HaiZeus0411/Infernum-Files/README.md

# Infernum Files
 Open sourced files for Infernum 35% Keyboard.  
This is a work in progress and more files can be uploaded upon request.  
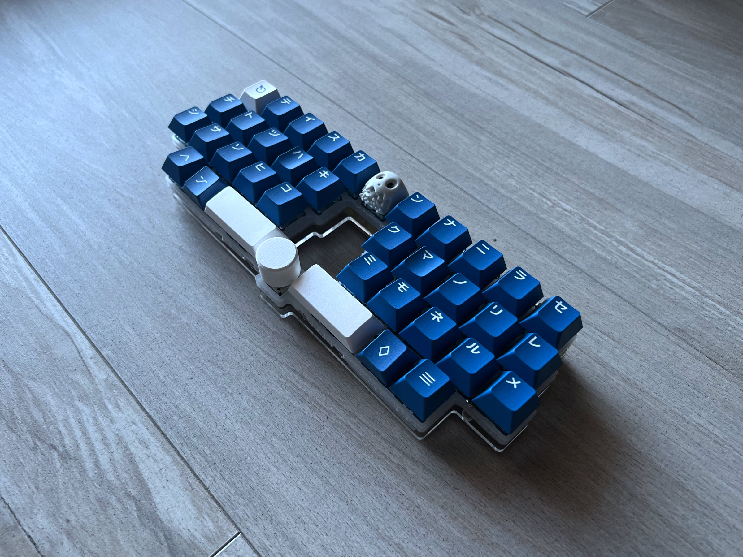
[picture p1: image.jpg]
Skeleton Kit

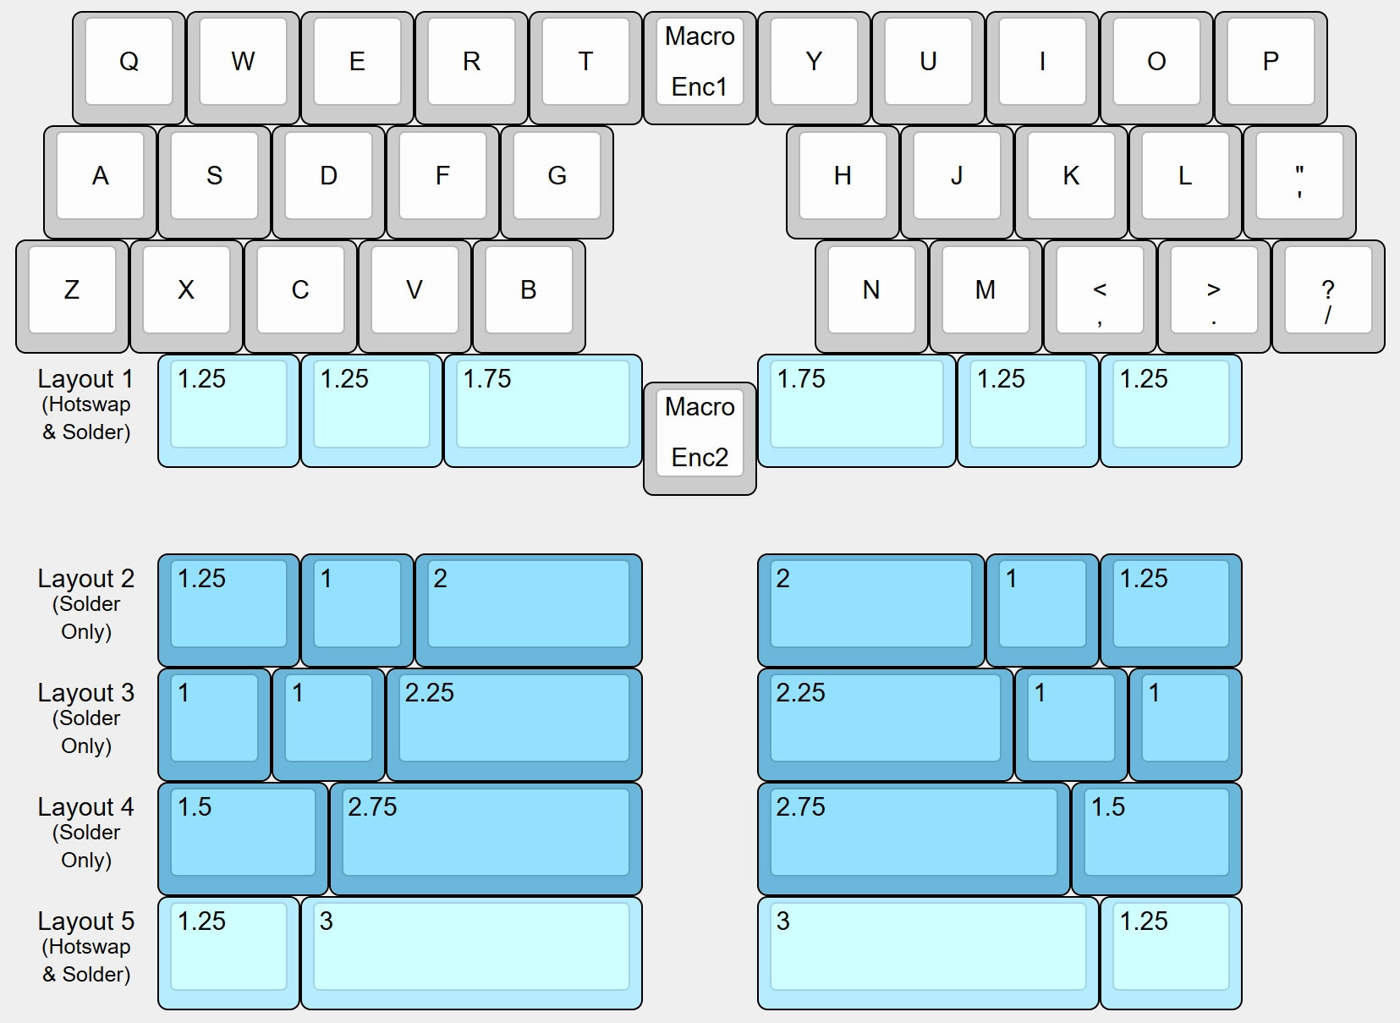
[picture p2: Infernum-Layout.jpg]
KLE
