HaiZeus0411/Infernum-Files/Useful Files for Custom Cases/README.md

# Useful Files for Custom Cases
Note: These files are for use in custom case design. The blocker is not perfectly centered in the center cutout of the PCB, so an additional DXF is provided showing their relative positon. The blocker is 18.50 mm tall and designed for M3x6mm screws.
