HaiZeus0411/Infernum-Files/Case Print Files/Leviathan5Deg_InternalWeight.stl

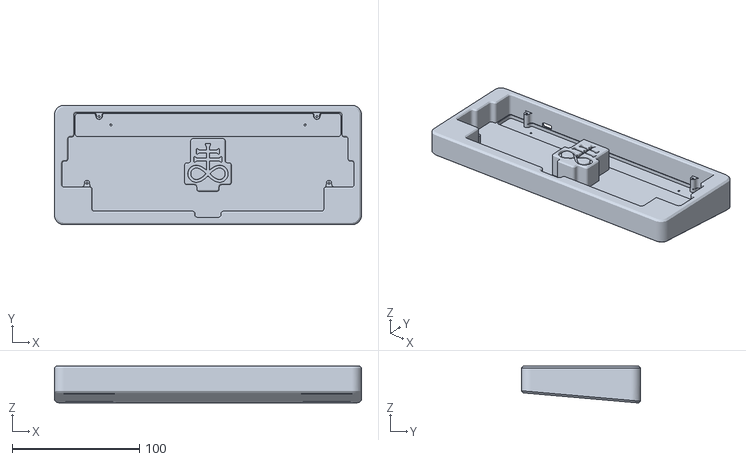
[picture p3: CAD file, 2024-08-07]
Case Print Files/Leviathan5Deg_InternalWeight.stl
241.6 x 94.0 x 29.1
