HaiZeus0411/Infernum-Files/Switch Plate Files/Infernum/HotswapPlate.dxf

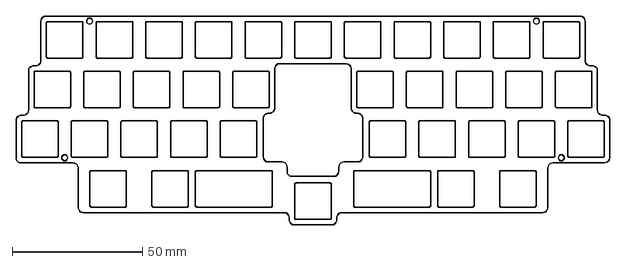
[picture p4: CAD file, 2025-10-07]
Switch Plate Files/Infernum/HotswapPlate.dxf
227.8 x 80.2 mm
