HaiZeus0411/Infernum-Files/Switch Plate Files/Pantagruel/PantagruelNaeviesPlate_M2Threaded.dxf

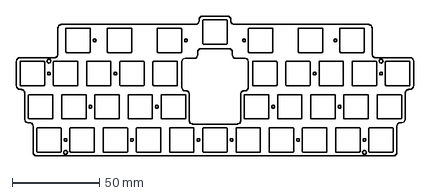
[picture p5: CAD file, 2025-11-03]
Switch Plate Files/Pantagruel/PantagruelNaeviesPlate_M2Threaded.dxf
227.8 x 80.2 mm
