HaiZeus0411/Infernum-Files/Useful Files for Custom Cases/Infernum PCB.step

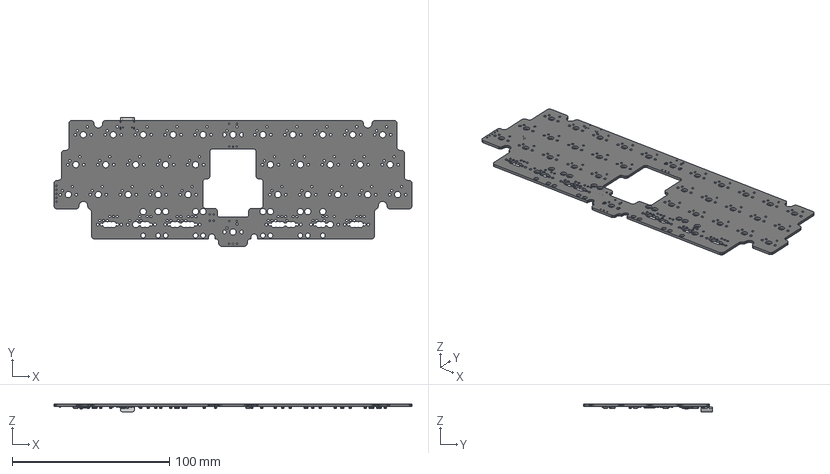
[picture p6: CAD file, 2025-10-07]
Useful Files for Custom Cases/Infernum PCB.step
227.8 x 81.9 x 4.84 mm
PCB
