HaiZeus0411/Infernum-Files/Case Print Files/5DegCase_ResinBlocker_InternalWeight.stl

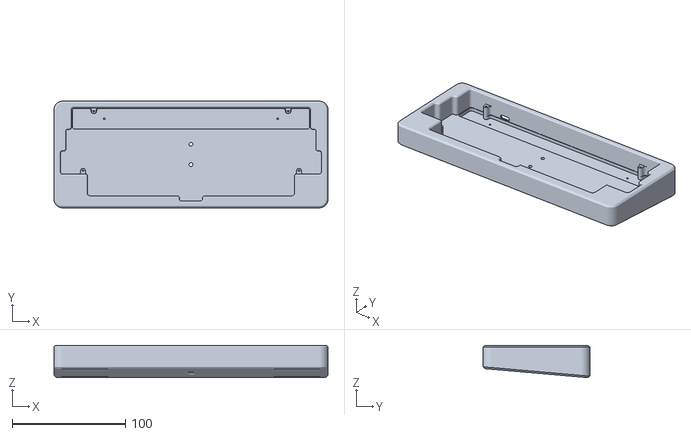
[picture p7: CAD file, 2024-08-07]
Case Print Files/5DegCase_ResinBlocker_InternalWeight.stl
241.6 x 94.0 x 28.6
