HaiZeus0411/Infernum-Files/Switch Plate Files/Infernum/UniversalThickPlate.stl

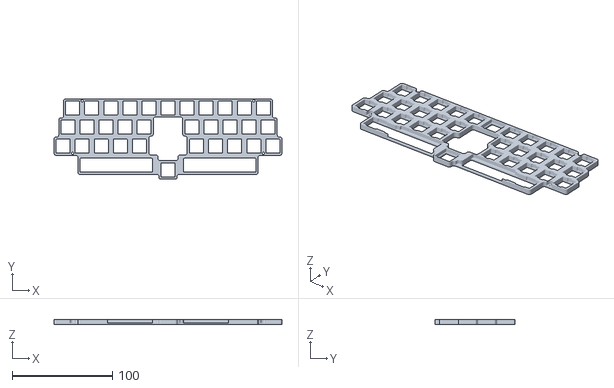
[picture p8: CAD file, 2025-10-07]
Switch Plate Files/Infernum/UniversalThickPlate.stl
227.8 x 80.2 x 4.75
