HaiZeus0411/Infernum-Files/Switch Plate Files/Infernum/175u_3u_ThickPlate_HotSwapLayouts.stl

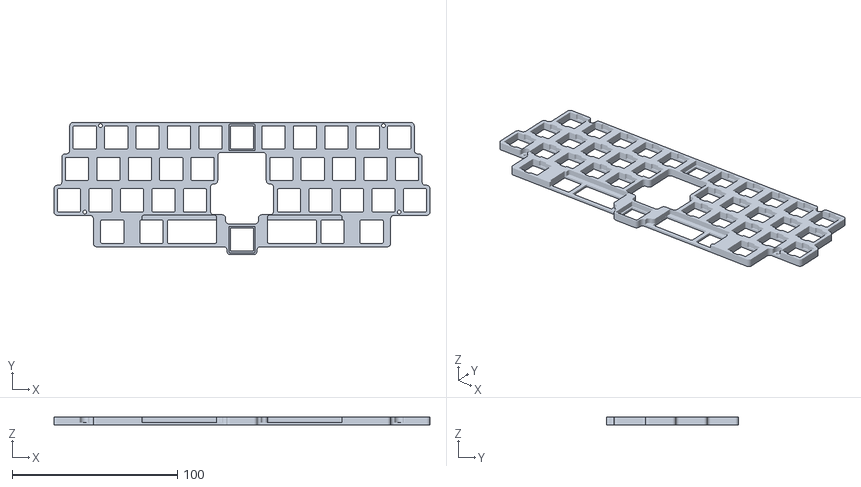
[picture p11: CAD file, 2025-10-07]
Switch Plate Files/Infernum/175u_3u_ThickPlate_HotSwapLayouts.stl
227.8 x 80.2 x 4.75
