HaiZeus0411/Infernum-Files/Switch Plate Files/Pantagruel/PantagruelToprePlate_M2Through.dxf

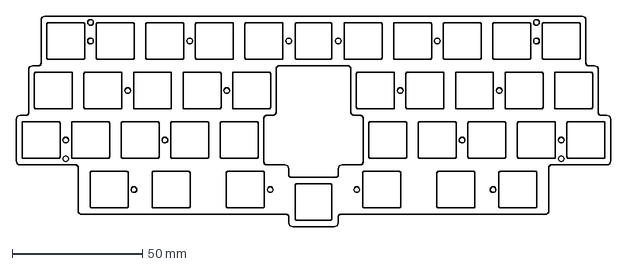
[picture p12: CAD file, 2025-10-07]
Switch Plate Files/Pantagruel/PantagruelToprePlate_M2Through.dxf
228.6 x 81.0 mm
