HaiZeus0411/Infernum-Files/Useful Files for Custom Cases/Infernum PCB Edge Cut with Blocker.dxf

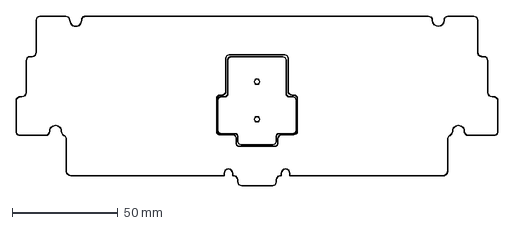
[picture p13: CAD file, 2025-10-07]
Useful Files for Custom Cases/Infernum PCB Edge Cut with Blocker.dxf
227.8 x 80.2 mm
