HaiZeus0411/Infernum-Files/Case Print Files/Trinity5Deg.stl

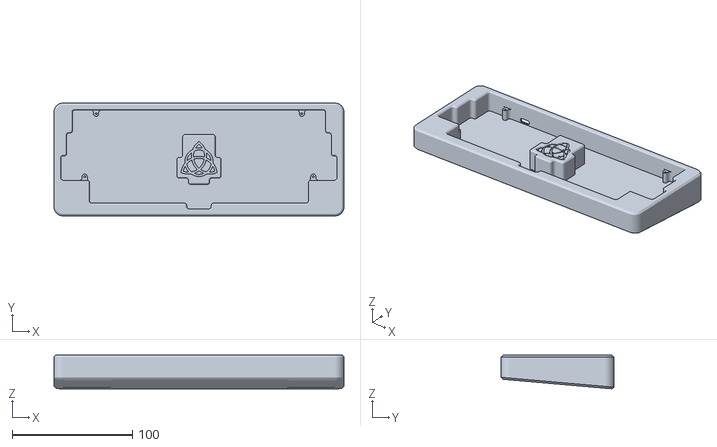
[picture p14: CAD file, 2023-12-13]
Case Print Files/Trinity5Deg.stl
241.6 x 94.0 x 28.1
