HaiZeus0411/Infernum-Files/Switch Plate Files/Infernum/175u_2u_ThickPlate.stl

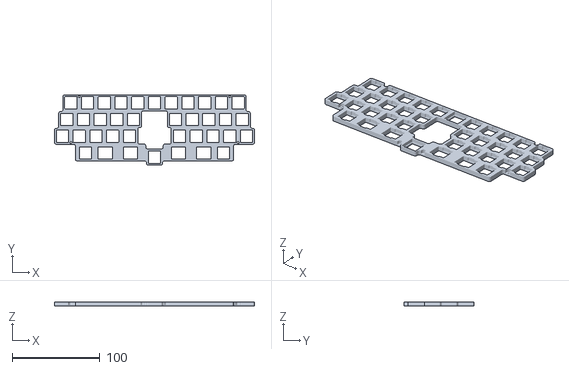
[picture p15: CAD file, 2025-10-07]
Switch Plate Files/Infernum/175u_2u_ThickPlate.stl
227.8 x 80.2 x 4.75
