HaiZeus0411/Infernum-Files/Useful Files for Custom Cases/Infernum Blocker.dxf

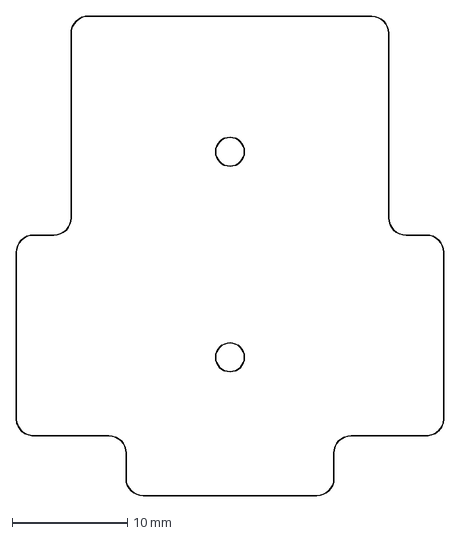
[picture p16: CAD file, 2025-10-07]
Useful Files for Custom Cases/Infernum Blocker.dxf
37.1 x 41.6 mm
