HaiZeus0411/Infernum-Files/Case Print Files/Leviathan3Deg.stl

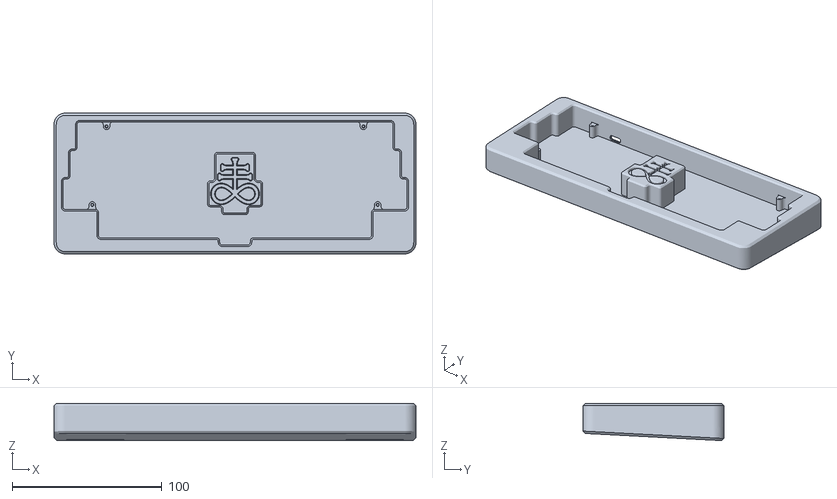
[picture p17: CAD file, 2023-12-13]
Case Print Files/Leviathan3Deg.stl
241.6 x 94.0 x 24.8
