HaiZeus0411/Infernum-Files/Switch Plate Files/Infernum/UniversalPlate.dxf

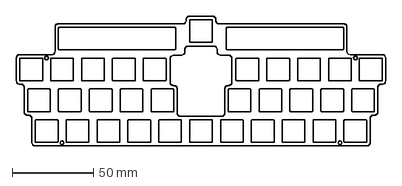
[picture p18: CAD file, 2025-10-07]
Switch Plate Files/Infernum/UniversalPlate.dxf
227.8 x 80.2 mm
