HaiZeus0411/Infernum-Files/Switch Plate Files/Pantagruel/PantagruelNaeviesPlate_M2Through.dxf

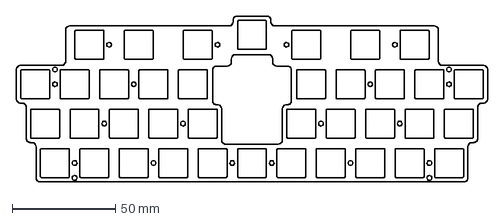
[picture p19: CAD file, 2025-10-07]
Switch Plate Files/Pantagruel/PantagruelNaeviesPlate_M2Through.dxf
227.8 x 80.2 mm
