HaiZeus0411/Infernum-Files/Case Print Files/Blank5Deg.stl

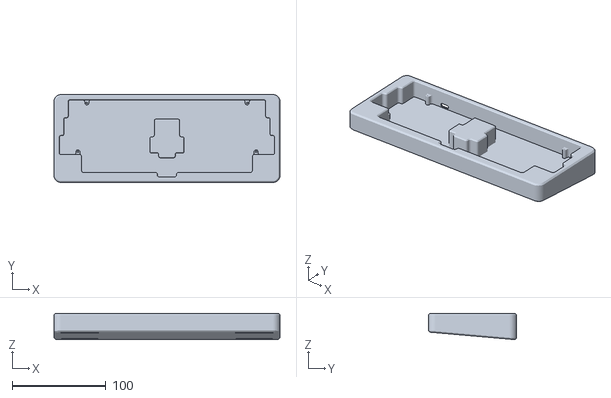
[picture p20: CAD file, 2023-12-13]
Case Print Files/Blank5Deg.stl
241.6 x 94.0 x 28.1
