HaiZeus0411/Infernum-Files/Case Print Files/Blank3Deg.stl

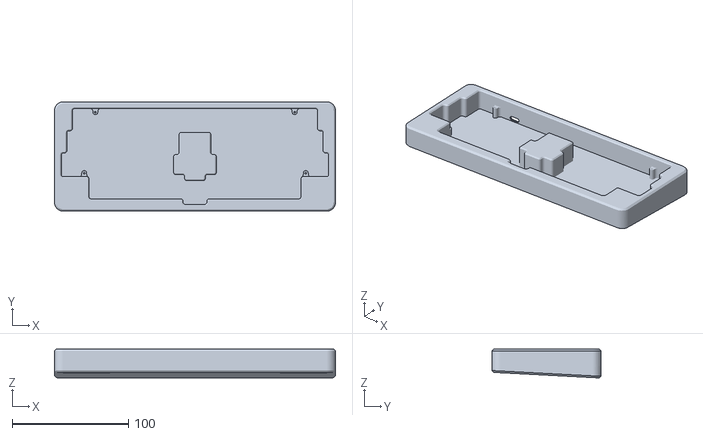
[picture p21: CAD file, 2023-12-13]
Case Print Files/Blank3Deg.stl
241.6 x 94.0 x 24.8
