HaiZeus0411/Infernum-Files/(list of files, cad)

Other CAD files:
Case Print Files/Trinity5Deg_InternalWeight.stl
Switch Plate Files/Pantagruel/PantagruelNaeviesThickPlate.stl
Case Print Files/Trinity3Deg.stl
Switch Plate Files/Infernum/3uOnlyThickPlate.stl
Switch Plate Files/Infernum/225u_275u_ThickPlate.stl
Case Print Files/Leviathan5Deg.stl
