HaiZeus0411/Infernum-Files/Build Guide/Guide.md

# Infernum Build Guide
Hardware included (1 extra of each):
 - 5x M2x5mm round head screws
 - 5x M2x10mm standoffs
 - 5x M2x6mm counter sunk screws
 - 3x M2x8mm counter sunk screws
 - 3x M2 hex nuts
 - 5x Silicone feet

Blocker variant will also include:
 - Choice of blocker
 - 3x M3x6mm counter sunk screws

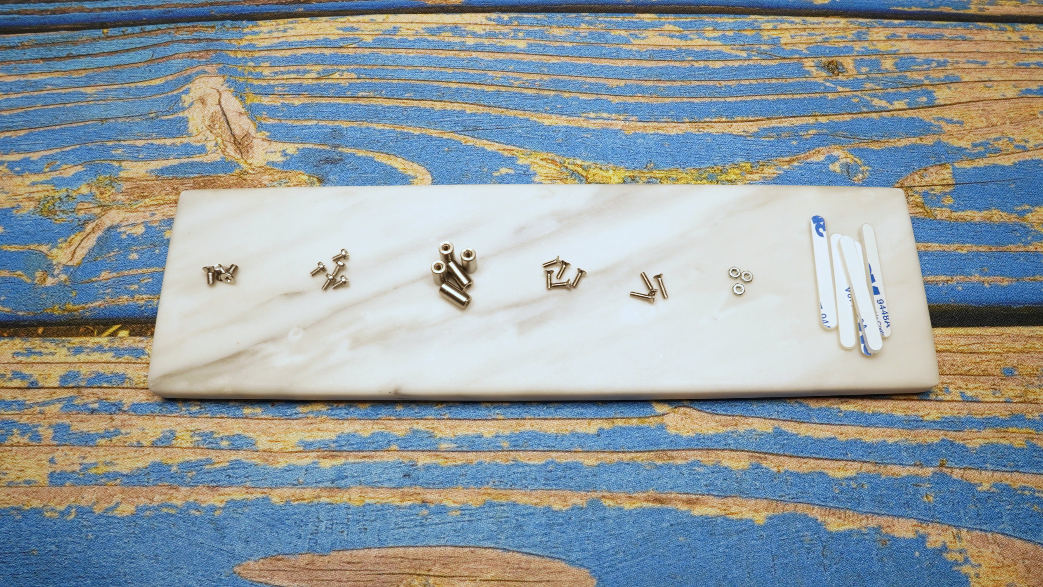
[picture p22: Build Guide/DSC00534.jpg]
Hardware
 

PCBs have been tested before shipping, however, it is always best to test a PCB before soldering as a precaution. If you are using encoders and/or stabilizers, make sure to install them before soldering on switches, as it will not be possible afterwards. Please reference the layout numbering in the below KLE when soldering the space bar switches. The layouts are numbered below each switch position on the PCB.

 KLE

This skeleton kit is the same as most other skeleton kits, with the distinguishing factor being the use of countersunk screws. All counter sunk screws are to be used on the bottom side of the acrylic bottom plate and foot. The photos below depict each step in the assembly process.

Step 1: Attach foot to bottom plate using M2x8mm counter sunk screws and M2 hex nuts. Counter sunk holes on foot and bottom plate must be facing the same direction.
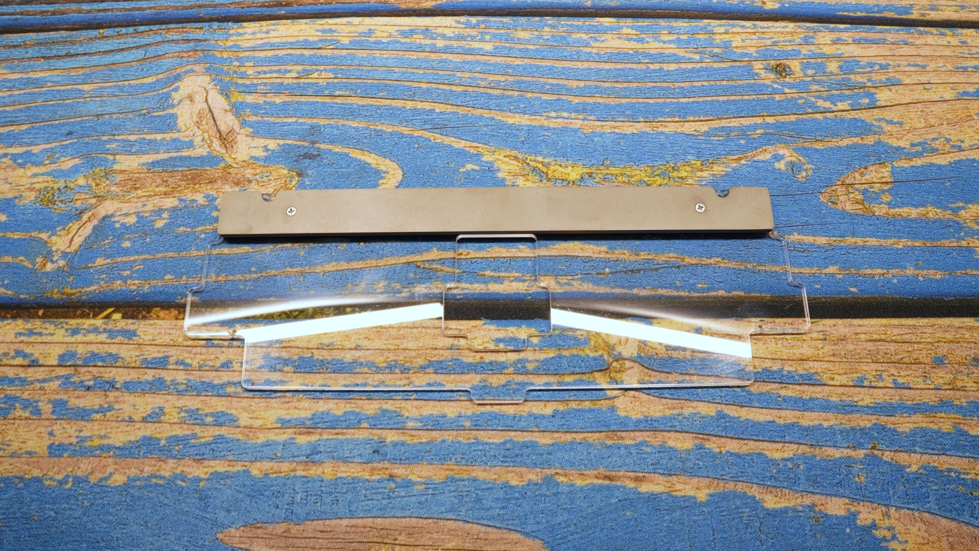
[picture p23: Build Guide/DSC00535.jpg]
Step 1
 

Step 2: Attach standoffs to bottom plate using M2x6mm counter sunk screws. Please note, foot should be on the opposite side of the standoffs.
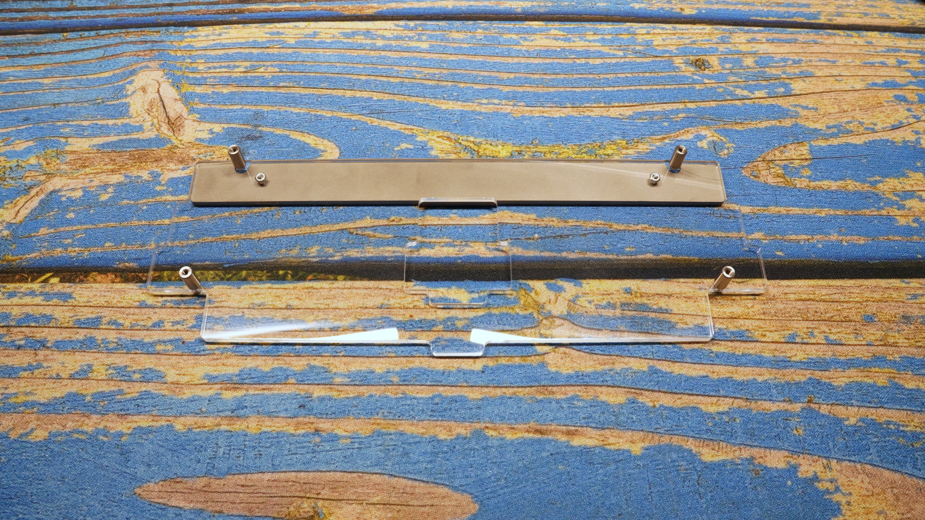
[picture p24: Build Guide/DSC00536.jpg]
Step 2
 

Step 3: Attach PCB-switch plate assembly to bottom plate using M2x5mm round head screws. 
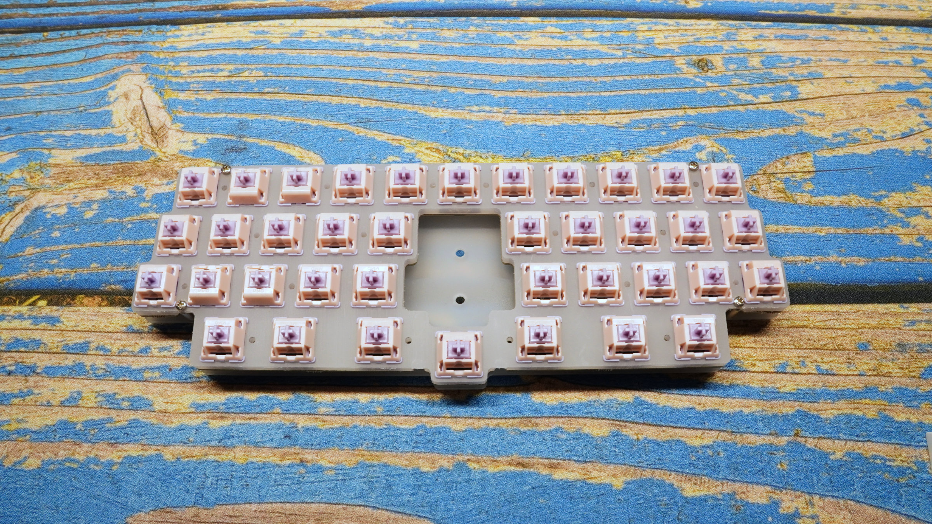
[picture p25: Build Guide/DSC00537.jpg]
Step 3
 

Steps 4 & 5: Attach silicone feet to bottom side. And, for blocker variant, attach blocker using M3x6mm counter sunk screws.
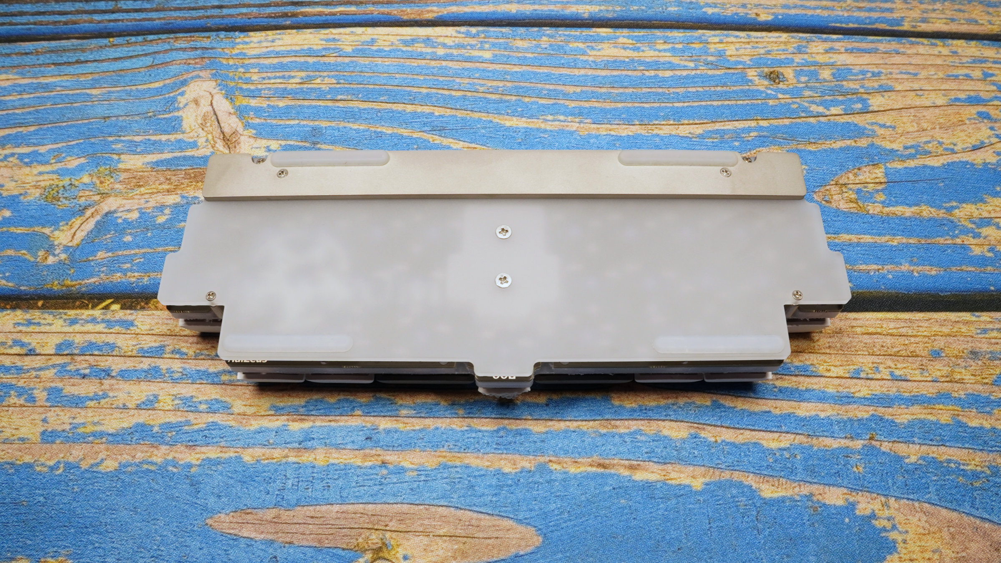
[picture p26: Build Guide/DSC00533.jpg]
Steps 4 & 5
 

Step 6: Add keycaps and enjoy!
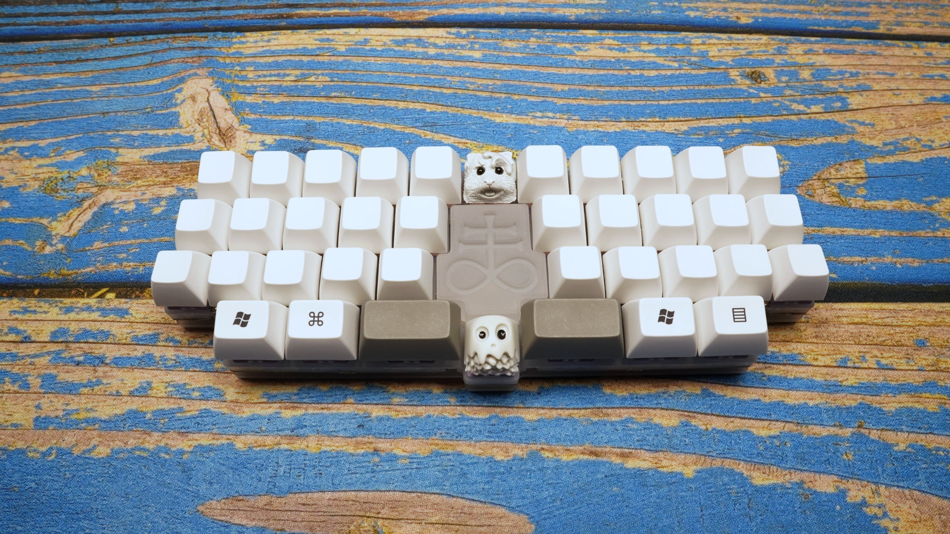
[picture p27: Build Guide/DSC00532.jpg]
Step 6
