HaiZeus0411/Infernum-Files/Firmware/pantagruel/config.h

/* Copyright 2023 sporkus
 *
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
 * You should have received a copy of the GNU General Public License
 * along with this program.  If not, see <http://www.gnu.org/licenses/>.
 */

#pragma once

// --- EC matrix user configuration ---
// Actuation/release threshold = idle + offset
// Larger offset = More key travel distance, less sensitive
// Sensitivity can be adjusted using keycode: EC_AP_I/EC_AP_D
#define ACTUATION_OFFSET 150
#define RELEASE_OFFSET 170
#define DEFAULT_IDLE 500      // default value before tuning is completed
// #define ECSM_DEBUG            // enables printing ec config and ADC readings */
#define EC_MATRIX            // allows ec code to be enabled with ifdef

// enables tuning ec config every power cycle, disable to reduce write cycle to flash
#define ECSM_TUNE_ON_BOOT

// --- Misc ---
#define DEBUG_MATRIX_SCAN_RATE

// --- Pin configuration ---
#define MATRIX_ROWS 5
#define MATRIX_COLS 10
#define EC_MATRIX_ROWS 4
#define EC_MATRIX_COLS MATRIX_COLS

#define EC_MATRIX_ROW_PINS \
    { A10, A13, A8, A9 }

/* offset the second multiplexer channel by 8 */
#define EC_MATRIX_COL_CHANNELS \
    { \
       3, 0, 1, 2, 4, \
       11, 8, 9, 10, 12 \
    }

#define MUX_SEL_PINS \
    { A7, B0, B1 }

#define MUX_EN_PINS \
    { A6, A5 }

#define DISCHARGE_PIN A4 // opamp v+/mux output
#define ANALOG_PORT A3   // opamp v_out/adc

// extra list of direct pins to read
#define EXTRA_SWITCHES 2                      // number of extra switches
#define EXTRA_SWITCH_ROW (MATRIX_ROWS - 1)    // the last row
#define EXTRA_SWITCH_PINS {B13, C13} 

// --- Persistent Storage config ---
// Data size is in bytes. uint16_t = 2 bytes
// data block size needs to be uint16_t array length * 2
// Two addition words for actuation offsets and one byte for configuration check
#define EECONFIG_KB_DATA_SIZE ((MATRIX_ROWS * MATRIX_COLS + 2) * 2 + 1)

#define ENCODER_MAP_ENABLE
