HaiZeus0411/Infernum-Files/Firmware/pantagruel/keymaps/vial/config.h

/* SPDX-License-Identifier: GPL-2.0-or-later */

#pragma once

#define VIAL_KEYBOARD_UID {0xFA, 0x63, 0x2F, 0xB8, 0xF7, 0x0E, 0x27, 0x94}
#define VIAL_COMBO_ENTRIES 64
#define DYNAMIC_KEYMAP_LAYER_COUNT 8
#define TAPPING_TERM 250
