HaiZeus0411/Infernum-Files/Firmware/pantagruel/keymaps/vial/keymap.c

// Copyright 2023 sporkus
// SPDX-License-Identifier: GPL-2.0-or-later

#include QMK_KEYBOARD_H

const uint16_t PROGMEM keymaps[][MATRIX_ROWS][MATRIX_COLS] = {
    [0] = LAYOUT(
  KC_TRNS, KC_TRNS, KC_TRNS, KC_TRNS, KC_TRNS, KC_TRNS, KC_TRNS, KC_TRNS, KC_TRNS, KC_TRNS, KC_TRNS, 
  KC_TRNS, KC_TRNS, KC_TRNS, KC_TRNS, KC_TRNS,          KC_TRNS, KC_TRNS, KC_TRNS, KC_TRNS, KC_TRNS, 
  KC_TRNS, KC_TRNS, KC_TRNS, KC_TRNS, KC_TRNS,          KC_TRNS, KC_TRNS, KC_TRNS, KC_TRNS, KC_TRNS, 
                    KC_TRNS, KC_TRNS, KC_TRNS, KC_TRNS, KC_TRNS, KC_TRNS, KC_TRNS
    ),

    [1] = LAYOUT(
  KC_TRNS, KC_TRNS, KC_TRNS, KC_TRNS, KC_TRNS, KC_TRNS, KC_TRNS, KC_TRNS, KC_TRNS, KC_TRNS, KC_TRNS, 
  KC_TRNS, KC_TRNS, KC_TRNS, KC_TRNS, KC_TRNS,          KC_TRNS, KC_TRNS, KC_TRNS, KC_TRNS, KC_TRNS, 
  KC_TRNS, KC_TRNS, KC_TRNS, KC_TRNS, KC_TRNS,          KC_TRNS, KC_TRNS, KC_TRNS, KC_TRNS, KC_TRNS, 
                    KC_TRNS, KC_TRNS, KC_TRNS, KC_TRNS, KC_TRNS, KC_TRNS, KC_TRNS
    ),

    [2] = LAYOUT(
  KC_TRNS, KC_TRNS, KC_TRNS, KC_TRNS, KC_TRNS, KC_TRNS, KC_TRNS, KC_TRNS, KC_TRNS, KC_TRNS, KC_TRNS, 
  KC_TRNS, KC_TRNS, KC_TRNS, KC_TRNS, KC_TRNS,          KC_TRNS, KC_TRNS, KC_TRNS, KC_TRNS, KC_TRNS, 
  KC_TRNS, KC_TRNS, KC_TRNS, KC_TRNS, KC_TRNS,          KC_TRNS, KC_TRNS, KC_TRNS, KC_TRNS, KC_TRNS, 
                    KC_TRNS, KC_TRNS, KC_TRNS, KC_TRNS, KC_TRNS, KC_TRNS, KC_TRNS
    )
};

#ifdef ENCODER_MAP_ENABLE
#undef BLANK_LAYER
#define BLANK_LAYER { ENCODER_CCW_CW(_______, _______), ENCODER_CCW_CW(_______, _______) }
const uint16_t PROGMEM encoder_map[][NUM_ENCODERS][2] = {
    [0] =   { ENCODER_CCW_CW(KC_VOLD, KC_VOLU), ENCODER_CCW_CW(KC_VOLD, KC_VOLU) },
    [1] =   BLANK_LAYER,
    [2] =   BLANK_LAYER
};
#endif
