HaiZeus0411/Infernum-Files/(commit log)

2023-12-13 Some case files published
    [Blank3Deg.stl, Blank5Deg.stl, Leviathan3Deg.stl, Leviathan5Deg.stl, Trinity3Deg.stl, Trinity5Deg.stl]
2023-12-17 Uploaded firmware and some design files
    [Infernum Blocker.dxf, Infernum PCB Edge Cut with Blocker.dxf, Infernum PCB Edge Cut.dxf, Infernum Universal Plate.dxf, Infernum Universal Thick Plate.stl]
2023-12-18 PCB step uploaded
    [Infernum PCB.step]
2024-02-18 updated firmware
    [Infernum Universal Thick Plate.stl]
2024-02-23 added build guide
    [Infernum Universal Thick Plate.stl]
2024-08-07 added cases
    [5DegCase_ResinBlocker_InternalWeight.stl, Leviathan5Deg_InternalWeight.stl, Trinity5Deg_InternalWeight.stl]
2025-10-07 Updated for round 2
    [175u_2u_ThickPlate.stl, 175u_3u_ThickPlate_HotSwapLayouts.stl, 225u_275u_ThickPlate.stl, 3uOnlyThickPlate.stl, HotswapPlate.dxf, Infernum Blocker.dxf, Infernum PCB Edge Cut with Blocker.dxf, Infernum PCB Edge Cut.dxf]
2025-11-03 Updated Pantagruel readme
    [175u_2u_ThickPlate.stl, 175u_3u_ThickPlate_HotSwapLayouts.stl, 225u_275u_ThickPlate.stl, 3uOnlyThickPlate.stl, HotswapPlate.dxf, PantagruelNaeviesPlate_M2Threaded.dxf, PantagruelNaeviesPlate_M2Through.dxf, PantagruelNaeviesThickPlate_175uOnly.stl]
